kimkyowon/Capstone_Design/README.md

# [드론 자동 착륙 장치]
- ## **착륙지의 AI 객체인식 시스템을 통해 호버링 중인 드론을 자동 착륙 시키는 시스템**

---

## 1. Project Summary (프로젝트 요약)
-   **개발 기간:**
    - [2024.12.01] ~ [2025.05.21]
  
-   **참여자   :**
    - 김교원
  
-   **주요 성과:**
    - 프로젝트 전 주기 경험
    - MissionPlanner 학습
    - 드론 HW 구조 학습
    - Colab 환경에서의 Yolo 모델 학습 방법 학습
    - **캡스톤 경진대회 장려상**

## 2. Tech Stack & Implementation (기술 스택 및 구현 핵심)

### 🛠️ 사용 기술
| Category | Skills |
| :--- | :--- |
| **Language** |   |
| **AI/Vision** |   |
| **Dev Boards** |   |
| **Tools & Platforms** |  |

### 💡 구현 핵심

-   **파트별 핵심 기능 / 포인트:**
    - 착륙지 : 객체 인식 후 2차원 좌표데이터 값을 기준으로 조이스틱 측으로 이동 명령, 위급상황시 정지 명령 등을 전달.
    - 조종기 : 실시간 조이스틱 및 버튼 값 갱신, 착륙지로부터 받은 데이터 처리, 모드 전환(자율 제어, 사용자 제어) 기능 탑재.
    - 무인기 : 원활한 원격 데이터 송수신을 위해 안테나 간섭을 최소화한 구조 설계.

-   **구조:**
    

## 3. Problem Solving & Learnings (문제 해결 및 배운 점)

-   **겪었던 문제:**
    > HW 셋업, AI 비전 인식 성능 향상, 테스트 시 인력 문제
    
-   **해결 과정:**
    > 시간이 오래 걸리더라도 이후 테스트를 위해 최대한 공식 사이트에서 제공된 가이던스를 따랐습니다.
    > 성능 향상을 위해 다각도의 데이터셋 추가, 학습량을 늘리며 실제 성능(주관적, 객관적 지표)이 고점을 찍은 시점에서 학습 중단, 카메라 모듈 (자동초점기능) 성능 고려하여 선정.
    
-   **배운 점 / 느낀 점:**
    > 개인 단위에서 어느정도 규모 있는 개발을 설계부터 자재 구매 이후 테스트 까지 전 과정을 겪어볼 수 있어서 좋았습니다.
    > 드론 관련 시스템에 대해 심도있게 배웠고 HW 세팅이 매우 중요하고 시간을 많이 잡아먹기에 다음 개발에서는 체계적인 계획을 세워야겠다는 것을 배웠습니다.

---
