kimkyowon/Capstone_Design/1.PrecisionLandingModule/1.ReasearchNote/ResearchNoteData.xlsx

Sheet: 임시 System 구성도
One handed Drone System |  |  |  |  |  |  | Landing Module System
Drone |  |  |  |  |  |  | Drone |  |  |  |  |  |  | Landing Station
 |  | FC (Flight Control) |  | GPS |  | Mission payload |  |  | FC (Flight Control) |  | GPS |  | BLE (Replaceable)
 |  |  |  |  |  |  |  |  |  |  |  |  |  |  | BLE | Control System (STM32F Series) |  | LCD Monitor(?)
 | RF module |  | FC Carrier Board |  |  |  |  | RF module |  | FC Carrier Board
 |  |  |  |  |  | ESC |  |  |  |  |  |  | ESC |  |  |  |  | IR Beacon
 |  |  | Battery (with BMS) |  |  |  |  |  |  | Battery (with BMS) | IR Sensor (Replaceable)
 |  |  |  |  |  | Motor |  |  |  |  |  |  | Motor
 |  |  |  |  |  |  |  |  |  |  |  |  |  |  |  | Battery + BMS | Button, LED(BAT Gauge)
GCS |  |  |  |  |  |  | GCS
 |  |  |  |  |  |  |  |  |  |  |  | Display (Vbat)
 |  |  |  |  |  |  |  |  |  | MCU (with hid interface feature)
 | RF module |  | MCU (with hid interface feature) |  | Tablet or Laptop |  |  | RF module
 |  |  |  |  |  |  |  |  |  |  |  | Battery
 |  |  | Sensor module (ex mpu9250 etc…) |  |  |  |  |  |  | Switch, Button Etc…

Sheet: 제품선정자료
 |  | 구분 | 파트 | 수량(ea) | 품명 | 제조사 | 단가(krw) | 장점 | 단점 | 링크 | 납기일
총가격 (KRW) | 434080 | Drone | FC | 1 | OrangeCube | Holybro | 0 | 고성능 FC, 보유중 | 중고 제품이라 기능 검증 좀 더 꼼꼼히 해야 함. | https://docs.px4.io/main/ko/flight_controller/cubepilot_cube_orange.html | 수령완료
최대납기일 | 0 |  | Carrier Board | 1 | OrangeCube에 포함됨. |  | 0 |  |  |  | 수령완료
수급불가능제품수 |  |  | Power module | 1 | PM02 V3 (2S~12S)_ DC 5.2V & 3A Max | Holybro | 30000 | 12S까지 수용 가능, JST,XT60등 FC에 바로 적용 가능한 Interface 작업 되어있음. | 간단한 기성품을 사는 느낌이라 금액적으로 아쉬운 부분(직접 하기엔 살게 많고, 된 걸 사기엔 아까운)이 있습니다. | https://silvus.co.kr/product/holybro-pm02-v3-power-module-12s-analog-%ED%94%BD%EC%8A%A4%ED%98%B8%ED%81%AC-pixhawk/39/
 |  |  | Battery | 1 | 4S1P PT-B2200N-SP (14.8V) |  |  |  |  |  | 수령완료
 |  |  | RF Module | 1 | SiK Telemetry Radio V3 (100mW 433Mhz) | Holybro | 47000 | PC 장착가능, |  | https://ko.aliexpress.com/item/1005006025972076.html?src=google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 | 수령완료
 |  |  | GPS | 1 | Ublox Neo M8N | ReadytoSky | 0 | 보유중, 개발 경험 있는 Ublox 시리즈 |  | https://www.readytosky.com/e_productshow/ | 수령완료
 |  |  | BLE | 1 | BoT-TMA50DS (+SMA Antenna) | Chipsen | 34200 | 장거리 통신 가능(고출력, 스펙 상 150m), 저전력 제품 | 고출력은 아니라 위성 개수 잡는데 오래걸릴 수 있음. | https://one-stop.co.kr/goods/view?no=25205
 |  |  | ESC | 4 | 35A BL BLHeli_S |  | 0 |  | 보유중인건 35A짜리라.. 낮은 거 찾아봐야 함. | https://ko.aliexpress.com/item/32860217492.html?src=google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 | 수령완료
 |  |  | IR Sensor | 1 | S2312-920KV |  | 57280 | 출력 높은 BLDC 모터 |  | https://sunnyskyusa.com/products/sunnysky-v3508-motor
 |  |  | ESC | 4 | F450 Dev kit |  | 170000 |  | 보유중인건 35A짜리라.. 낮은 거 찾아봐야 함. | https://www.rcbank.co.kr/shop/goods/goods_view.php?goodsno=20749&category=064014002 | 수령완료
 |  |  | Motor | 4 |  |  |  | 출력 높은 BLDC 모터
 |  | Drone (HW) | Frame | 1
 |  |  | Propeller | 4
 |  |  | Landing Skid | 4
 |  |  | GPS Mount | 1
 |  | GCS (HW) | Evaluation Board | 1 | Arduino Micro (enable HID) | Arduino | 0 | 보유중인 제품 HID가 가능하여 MissionPlanner PC 앱 호환 가능 |  |  | 수령완료
 |  |  | Bat Display | 1 | 잔량 표기 모듈 | ? | 7200 | 잔량 확인 시 0~100%로 확인 가능 | 전압을 기준으로 재기 때문에 정확하진 않음 | https://www.devicemart.co.kr/goods/view?no=1383971
 |  |  | Battery | 1 | 루나볼트 배터리 | LunaVolt |  | 지인통해 확보 가능 제품이며 수차례 검증한 제품 |  | https://lunavolt.com/product/list.html?cate_no=56
 |  |  | Button (Push) | 2 | 가져온것 (확인 중) 중국산이라 그런지 자료가 잘 없습니다 ㅠ |  |  | 수차례 검증해봤던 제품 보유중입니다. |  |  | 수령완료
 |  |  | Button (Push lock) | 2 | 가져온것 (확인 중) 중국산이라 그런지 자료가 잘 없습니다 ㅠ |  |  | 수차례 검증해봤던 제품 보유중입니다. |  |  | 수령완료
 |  |  | JoyStick | 2 | 가져온것 (확인 중) 중국산이라 그런지 자료가 잘 없습니다 ㅠ |  |  | 수차례 검증해봤던 제품 보유중입니다. |  |  | 수령완료
 |  | GCS (PC) | RF Module | 1 | SiK Telemetry Radio V3 (100mW 433Mhz) | Holybro | 47000 | PC 장착가능, |  | https://ko.aliexpress.com/item/1005006025972076.html?src=google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 | 수령완료
 |  | Landing Station | BLE | 1 | BoT-TMA50DS (+SMA Antenna) | Chipsen | 34200 | 장거리 통신 가능(고출력, 스펙 상 150m), 저전력 제품 |  | https://one-stop.co.kr/goods/view?no=25205
 |  |  | Control System | 1 | STMF401RE | STM | 0 | 보유중인 제품, 고성능 제품 |  | https://www.digikey.kr/ko/products/detail/stmicroelectronics/NUCLEO-F401RE/4695525?gad_source=4 | 수령완료
 |  |  | Battery | 1 | 루나볼트 배터리 | LunaVolt | ?? | 지인통해 확보 가능 제품이며 수차례 검증한 제품 |  | https://lunavolt.com/product/list.html?cate_no=56
 |  |  | Bat Display | 1 | 잔량 표기 모듈 | ? | 7200 | 잔량 확인 시 0~100%로 확인 가능 | 전압을 기준으로 재기 때문에 정확하진 않음 | https://www.devicemart.co.kr/goods/view?no=1383971
 |  |  | IR Beacon | 1
 |  |  | Switch | 2 | 가져온것 (확인 중) 중국산이라 그런지 자료가 잘 없습니다 ㅠ |  |  | 수차례 검증해봤던 제품 보유중입니다. |  |  | 수령완료

Sheet: (OrangeCube로 변경됨) FC 선정 자료
FC | Flight Controller 의 약자, 중앙 제어부라고 생각하시면 편하기에 해당 모듈의 성능이 좋을 수록 제품 퀄리티가 올라갑니다.
이슈 사항 | 원래 강의 자료가 제공되는 MH-FC V2.2 를 구매하려 하였으나(자료에 기반하여 진척도 보고가 용이하여), GPS와 자동 제어 부문에서 미구현된 점, 소비자가 모든 코드를 제작해야하는데 비싼 점, PID 제어나 고도 제어 테스트 영상에서 안정적이지 못한 성능 등의 사유로 다른 FC 선정이 필요했습니다.
요구 스펙 | Protocol | Mavlink protocol 제공되어야 좋음, 그 외에 다른 Protocol이면 API 자료를 확인해보아야 함.
 | MCU | STM계열 또는 ARM Processor면 좋습니다.
 | Interface | Serial1 (GPS), Serial2(BLE), I2C (Beacon), External Power (BAT), PWM(mission), 등등 다양한 포트 필요
 | 내부 모듈 | IMU, 기압 센서, 등
제품 선정 | Pixhawk 6c mini
사유 | 각종 Parameter 제공 (https://ardupilot.org/copter/docs/parameters.html) 안정성 높은 Mavlink Protocol 사용 기존 MH 제품보다 싼데 훨씬 좋음 (성능, 타 제품 호환성, 안정성 등) 여러가지 interface 제공 MissionPlanner (PC Program)과 호환 가능 (Mavlink써서?)

Sheet: Sheet1
https://www.youtube.com/watch?v=i5lE2cWJJhM

Sheet: Sheet2
대략적인 드론 구성 | 사용하게 될 제품군 (초안)
