kimkyowon/Capstone_Design/1.PrecisionLandingModule/2.Version_1.0/3.LandingStation/1.Src/1. YOLOv8_detect_drones_model/Test/Origin/Origin4.png

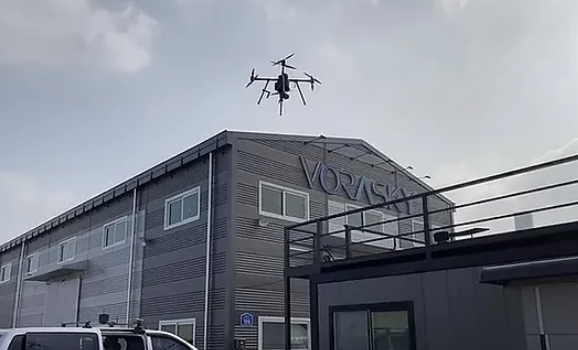
1.PrecisionLandingModule/2.Version_1.0/3.LandingStation/1.Src/1. YOLOv8_detect_drones_model/Test/Origin/Origin4.png
