kimkyowon/Capstone_Design/(commit log)

2024-09-18 초기 폴더 구성 정의 (임시이므로 변동될 수 있습니다)
    [ResearchNoteData.xlsx]
2024-09-19 2주차 활동 업로드 (현재 두서없이 작성중이나, 3주차 활동에 커밋메시지 규칙 생성하여 변경할 예정)
    - 과제 제안서 (ProjectDescription.hwp) 추가
    => 현재 두서없이 작성되었고 현재와 다른 부분이 있으므로, 추후 활용처가 생기면 업데이트할 예정
    - 연구노트 업데이트 (ResearchNote.docx, ResearchNoteData.xlsx)
    => 자재 선정 관련 전체 변경(Pixhawk FC에 맞춰 변경)
    => 파일 관리 방식에 대한 안내 기재 (ResearchNote.docx의 8페이지)
    - Datasheet,Specsheet 추가 중
    => 현재 FC만 추가하였음.
    [ResearchNoteData.xlsx]
2024-09-25 [docs] : README.md initialize README.md 파일 초기 업로드 (커밋 메시지 규칙)
2024-09-29 [docs] "ResearchNote.docx"의 3주차 내용 작성 (FC 기능 검증 관련). "ResearchNoteData.xlsx"의 FC 모델 변경 (더 고성능 FC를 얻게 되어). "TestVideo.zip" 테스트 영상 (FC 단독, FC의 PWM출력 기능) 업로드.
    [feat] "PwmTestCode_Arduino.zip" 아두이노를 활용한 PWM 테스트 코드 업로드.
    [ResearchNoteData.xlsx]
2024-10-06 [docs] "ResearchNote.docx"의 4주차 내용 작성 (Drone dev kit + Telemetry 구매) "ResearchNoteData.xlsx"의 "제품선정자료" 수정 (Drone kit 추가, GCS PC 부분 수정)
    [ResearchNoteData.xlsx]
2024-12-12 임시 커밋 (중간 저장용)
    [ResearchNoteData.xlsx]
2024-12-13 [Feat] Capstone_Design\1.PrecisionLandingModule\2.Version_1.0\2.GroudControlStation\1.Src 경로에 Joystick Fw 추가 [Docs] Capstone_Design\1.PrecisionLandingModule\1.ReasearchNote 경로의 ResearchNote.docx 업데이트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
2025-02-25 [Feat] C:\Users\vvvsk\Desktop\Git\Capstone_Design\1.PrecisionLandingModule\2.Version_1.0\3.LandingStation\1.Src\1. YOLOv8_detect_drones_model 경로에 Detect_drones_Capstone.ipynb 추가 (학습 모델 세팅)
2025-03-13 [Add] dataset and .ipynb
    [yolov2-tiny-voc-updated.cfg, yolov2-tiny-voc.cfg]
2025-03-14 [Add ] Test sample [Modify] Makefile, Detect_drones_Capstone.ipynb and yolov2-tiny-voc.cfg
    [yolov2-tiny-voc.cfg]
2025-03-23 [Change] .ipynb files (for YoloV8n model) [ADD ] ResearchNote (03.23)
    [Test_Training_Result.xlsx, yolov2-tiny-voc-updated.cfg, yolov2-tiny-voc.cfg]
2025-03-28 [ ADD ] Test/Test_Training_Result.xlsx best.onnx files (Model Outputs) [Update] ResearchNote.docx
    [Test_Training_Result.xlsx]
2025-03-28 [ ADD ] raspberrypicam_sample.py (sample code in raspberry pi) [Update] ResearchNote(1).pdf
2025-04-06 [ ADD ] raspberrypi_do_mission.py (sample code landing system sw ) ResearchNoteData.xlsx -> Landing System Flow sheet [Update] ResearchNote.pdf
2025-04-10 [ ADD ] : Joystick Code 신규 생성 및 임시 테스트 완료.
2025-04-13 [Feat] joystick fw 기능 추가 (sendState - MissionPlanner 로의 데이터 전송)
2025-04-13 [feat] debounceButton changeMode (with button)
    [chore] Change Button ISR ( before : split Falling and Rising // after : combine Change)
2025-04-15 [ ADD ] Signal 기반 자동 제어 기능 추가 드론 자동 제어 기능 중 정지 기능 추가 [ Fix ] State_diffJoysticks 판별 버그 수정 (맨 마지막 배열 값에 의존되던 것 해결)
    [PSL_GCS.cpp, PSL_GCS.h, PSL_GCS.ino]
2025-04-16 [ADD] 학습 결과 파일 추가 (185회, 설정값) epochs=600, # 1. epochs 증가 (300~600 권장) batch=-1, # 2. autobatch 활성화 (T4 메모리 최적화) imgsz=640, patience=50, # 3. early stopping 설정 lr0=0.01, # 4. 학습률 조정 weight_decay=0.000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
2025-04-22 [Feature] RaspberryPi - Set I2c Line, Make Command for moving drone [Update ] ResearchNote
2025-05-04 [Feature] ADD Landing Command (add Command Byte and send command)
2025-05-05 [chore] activate button2 for Return To Launch(RTL) feature
2025-05-05 [Modify] 최종 발표 PPT 내용 수정
2025-05-11 [ADD] add Documents about FinalReport
    [ParamList.param, Parameter 변경 목록.txt]
2025-05-17 [Feature] calculate remain distance and control with distance. [ Chore ] change Button ValidTime 3000 -> 1000
2025-05-25 SemiFinal Upload
    [Parameter 변경 목록.txt]
